boredfifo/Prototyping-Group-2/IR sensor.JPG

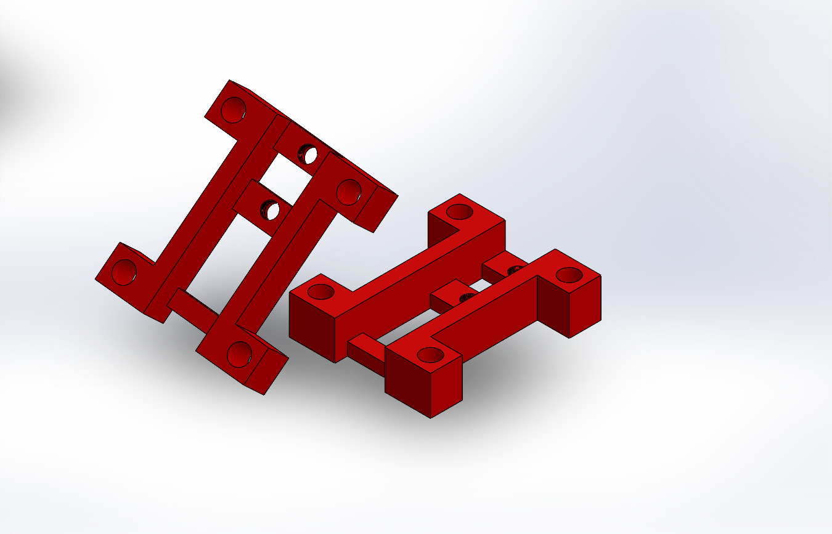
IR sensor.JPG
