boredfifo/Prototyping-Group-2/motor holder.JPG

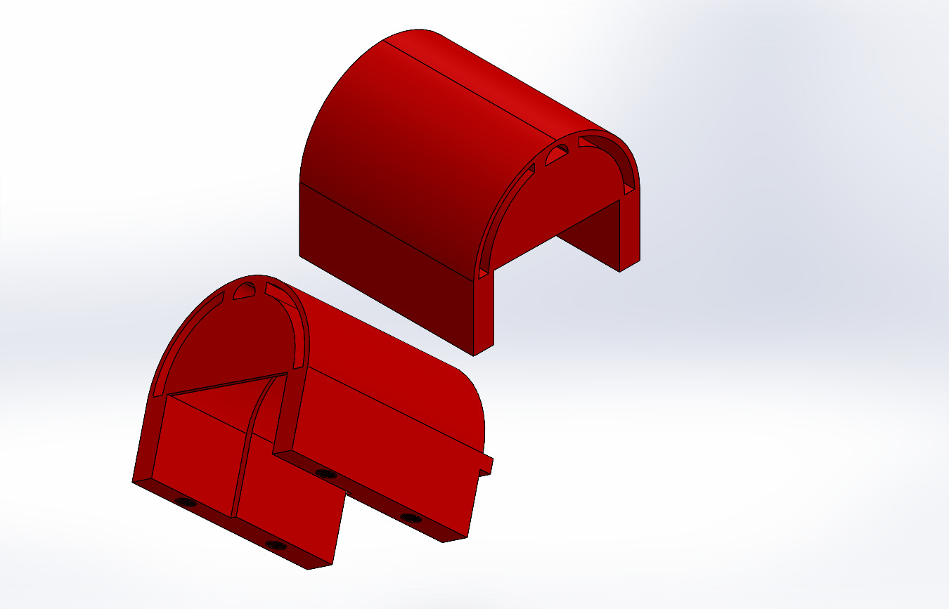
motor holder.JPG
