boredfifo/Prototyping-Group-2/README.md

# Prototyping-Group-2
Moiz Zaheer Malik,
Akinwande Mofifoluwa Ipadeola,
Karimi Arya,
Qaiser Mustafa,
