boredfifo/Prototyping-Group-2/Activity Diagram Prototyping.jpeg

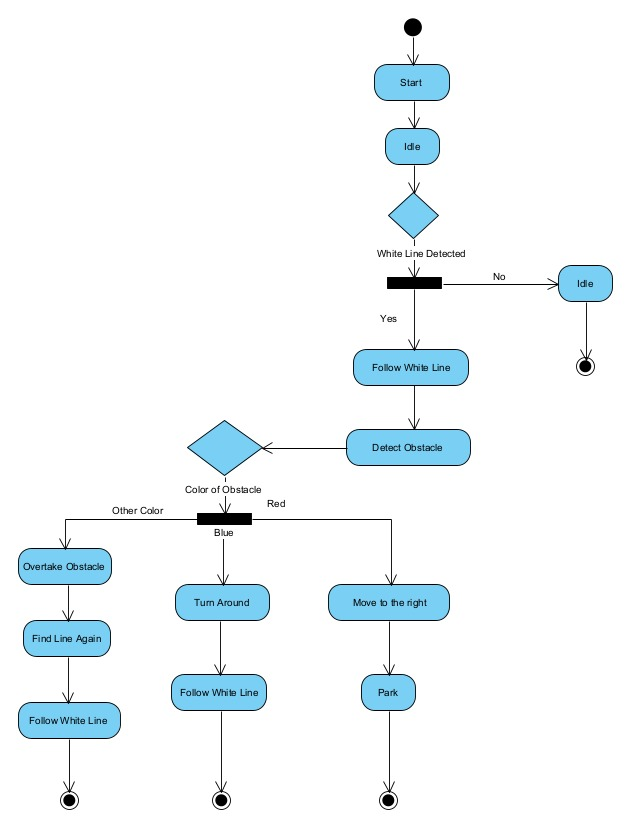
Activity Diagram Prototyping.jpeg
