boredfifo/Prototyping-Group-2/back wall.jpg

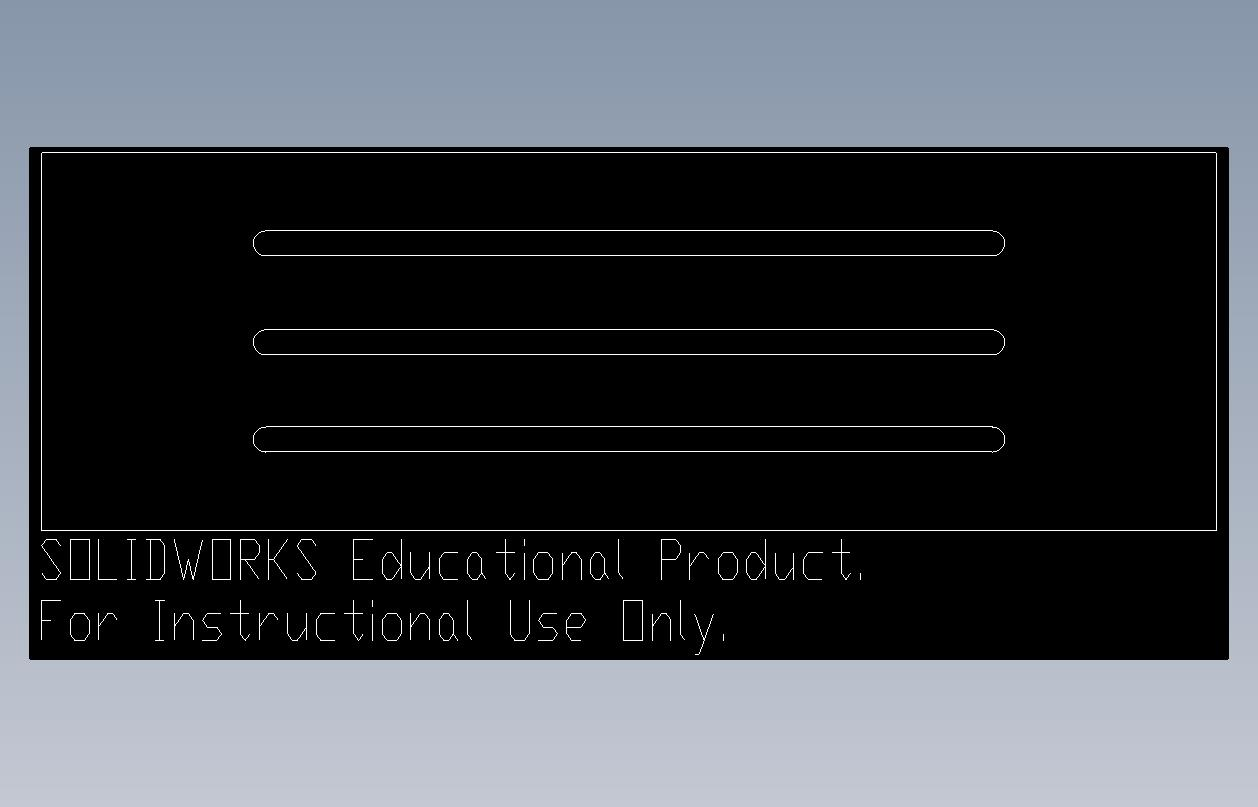
back wall.jpg
