boredfifo/Prototyping-Group-2/color sensor.JPG

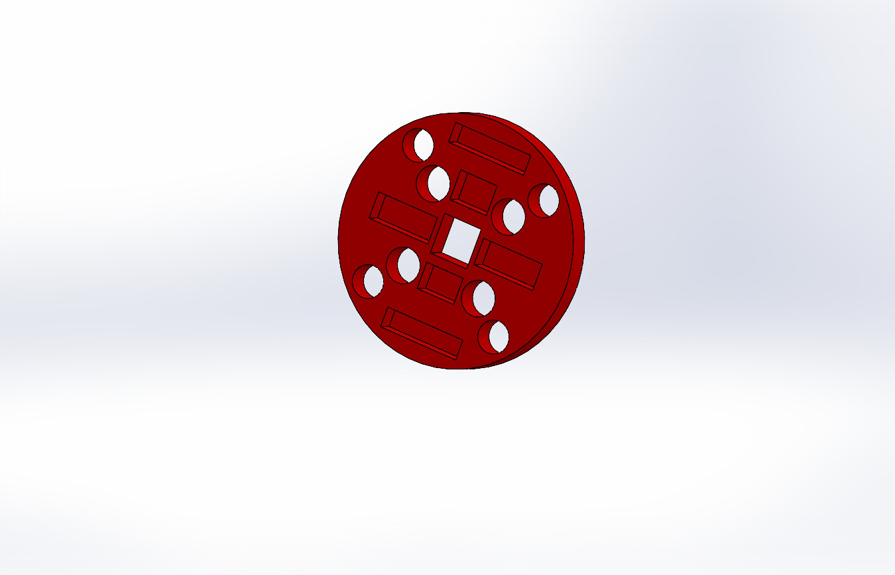
color sensor.JPG
