boredfifo/Prototyping-Group-2/front curved wall.jpg

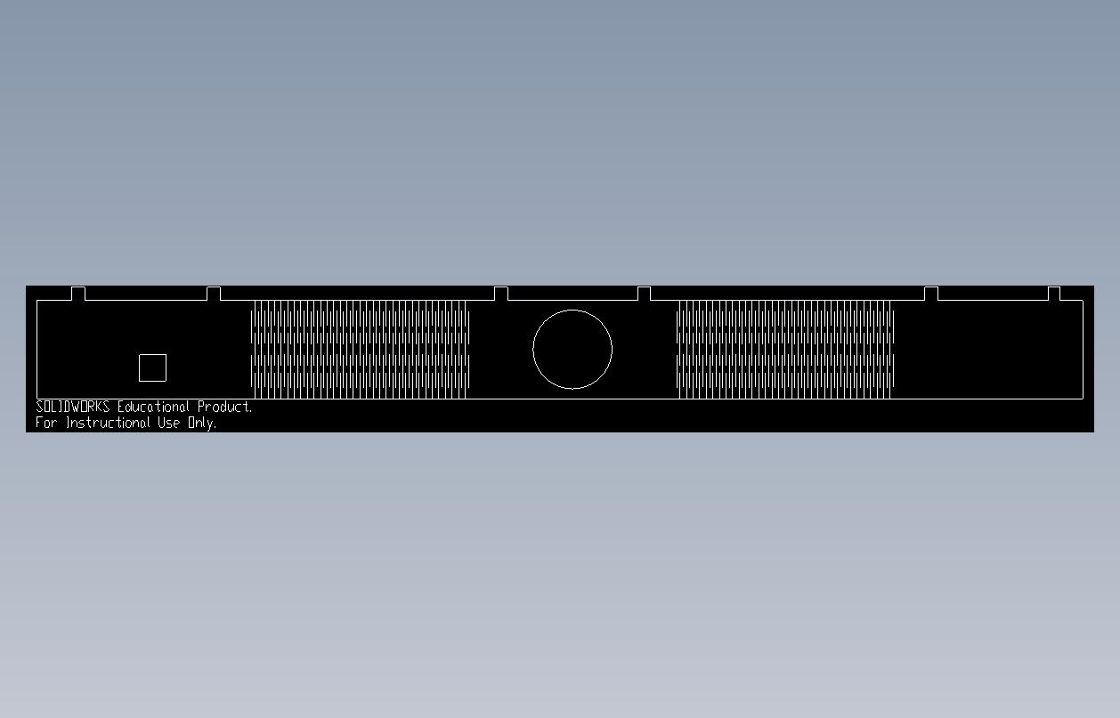
front curved wall.jpg
