boredfifo/Prototyping-Group-2/main body bottom 2.JPG

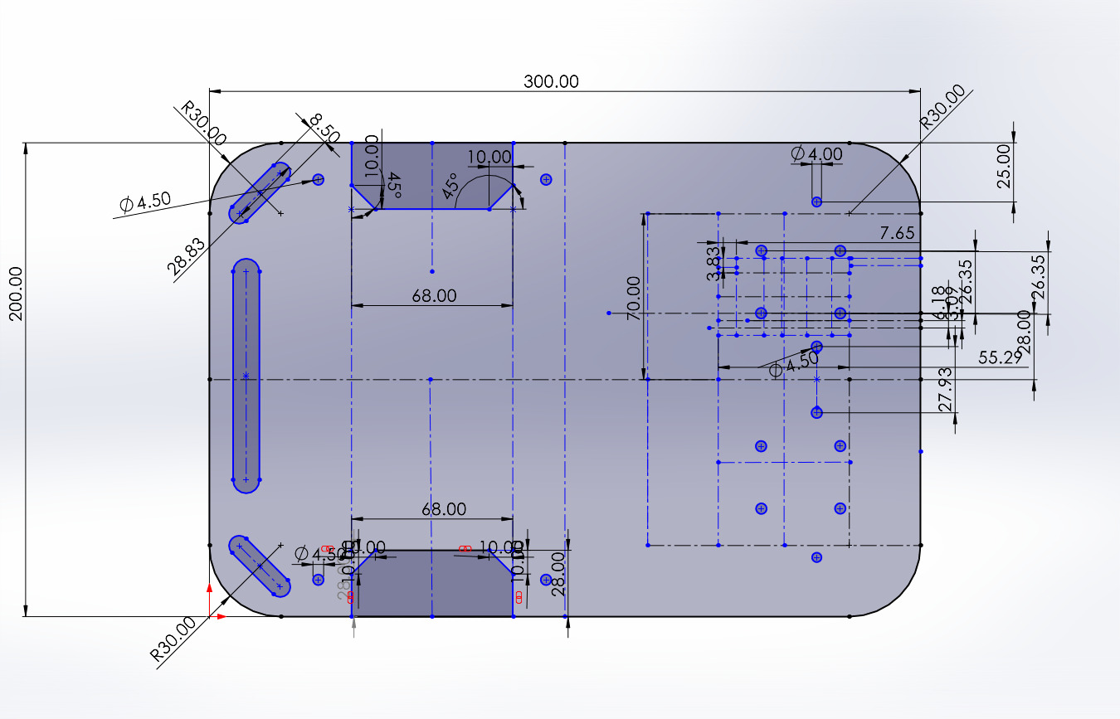
main body bottom 2.JPG
