boredfifo/Prototyping-Group-2/requirment digram.jpg

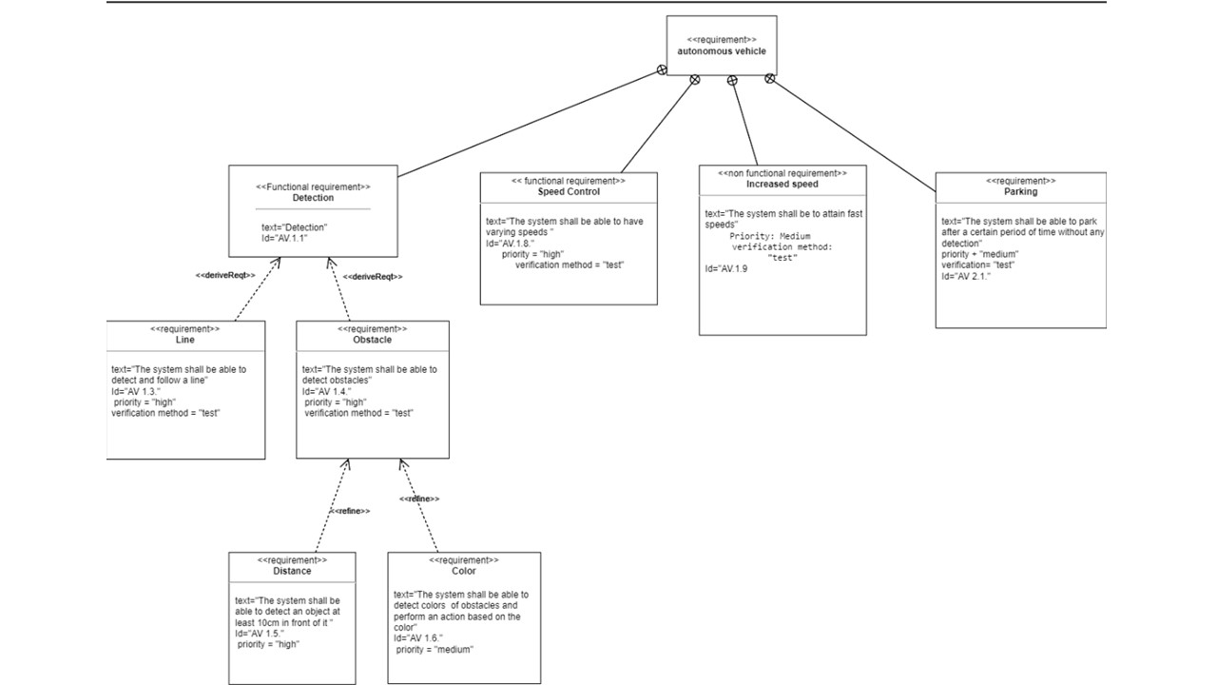
requirment digram.jpg
