boredfifo/Prototyping-Group-2/Slide1.JPG

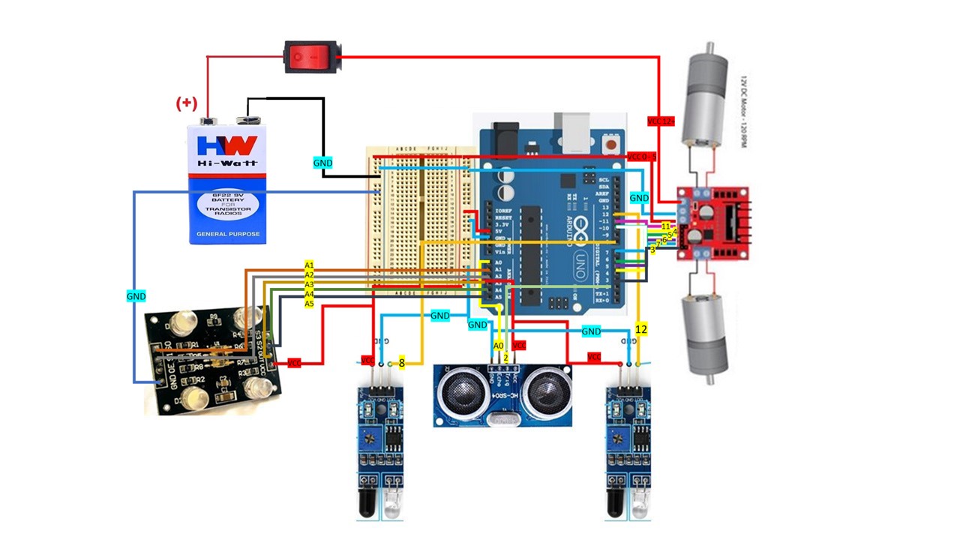
Slide1.JPG
