boredfifo/Prototyping-Group-2/solidworkspart.jpg

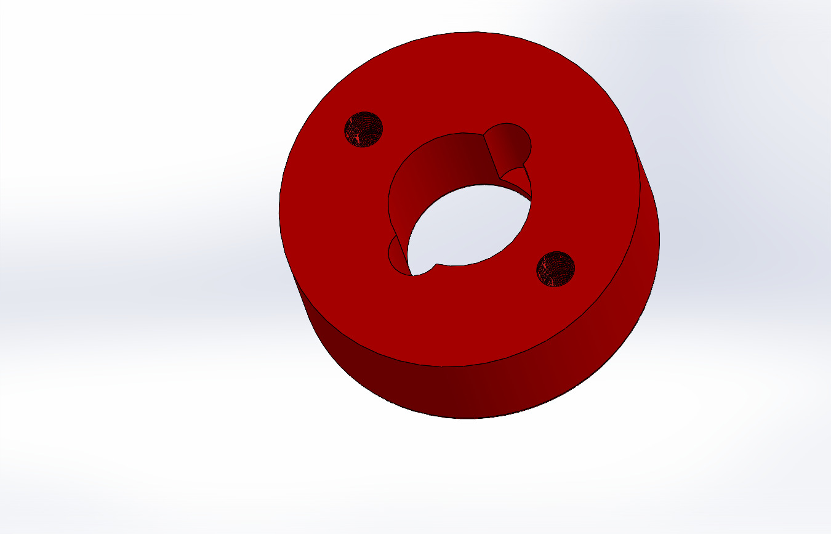
solidworkspart.jpg
