boredfifo/Prototyping-Group-2/state chart.png

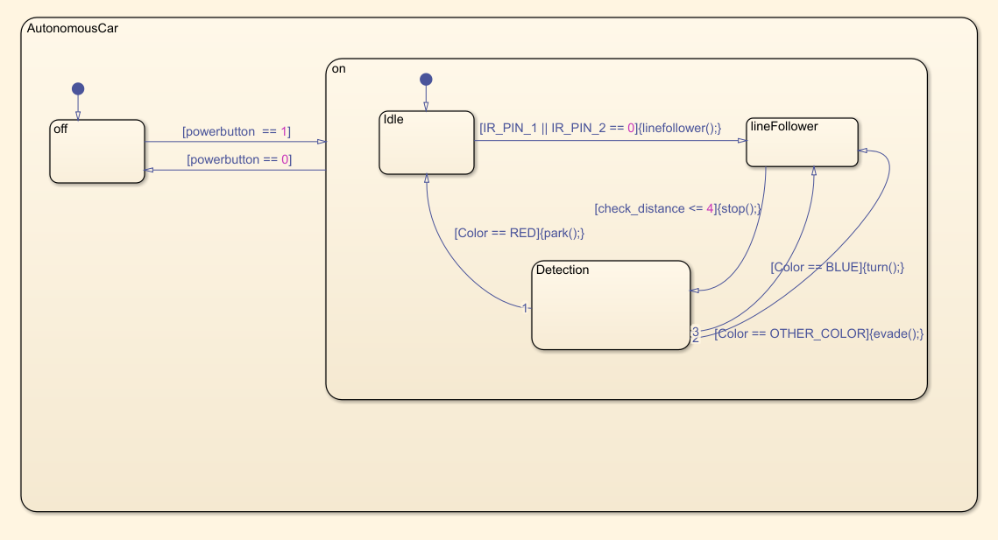
state chart.png
