boredfifo/Prototyping-Group-2/swp1.jpg

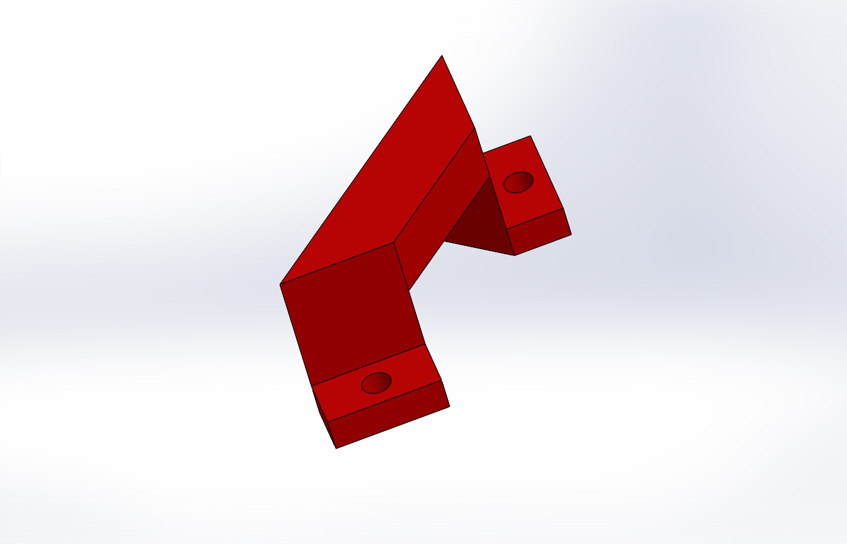
swp1.jpg
