boredfifo/Prototyping-Group-2/swp2.jpg

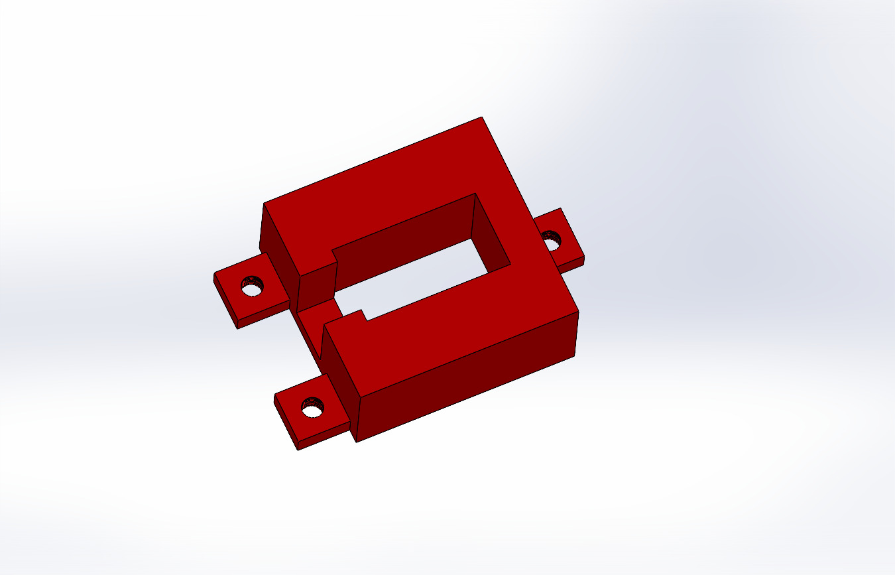
swp2.jpg
