boredfifo/Prototyping-Group-2/swp3.jpg

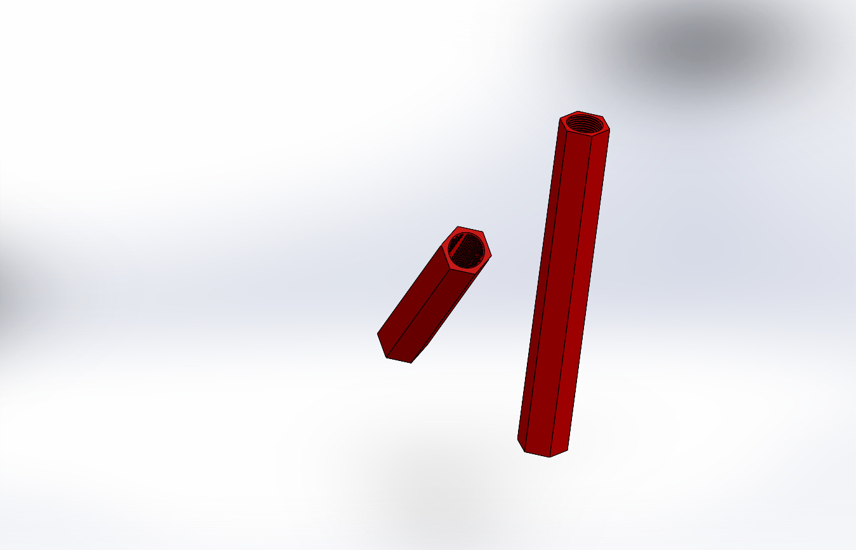
swp3.jpg
