boredfifo/Prototyping-Group-2/Systems Diagram Prototyping.jpeg

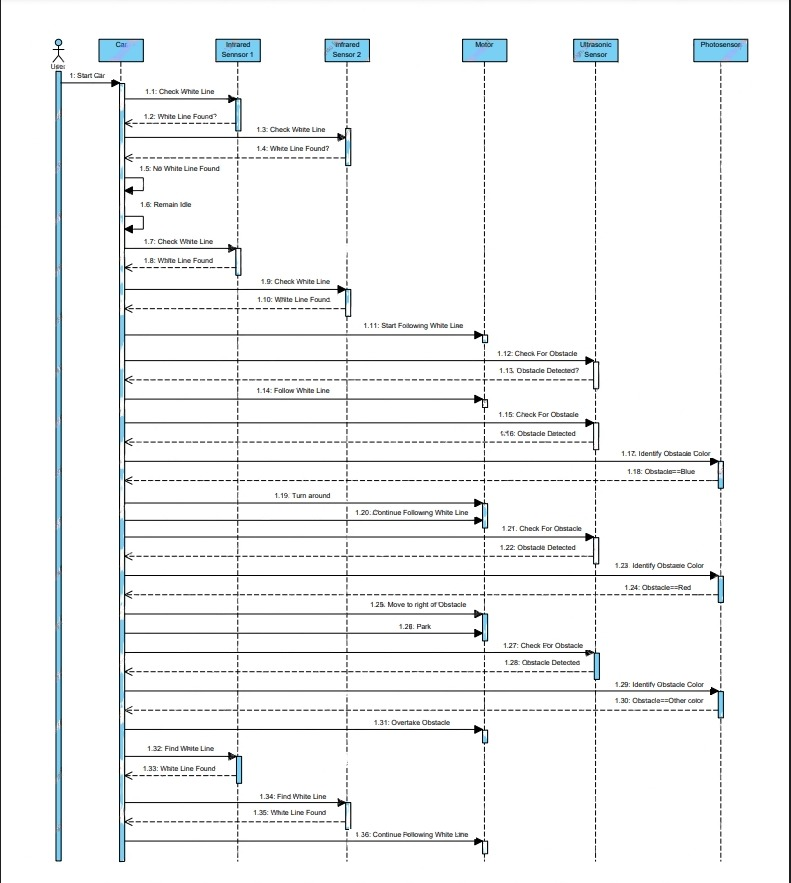
Systems Diagram Prototyping.jpeg
