boredfifo/Prototyping-Group-2/top body part.JPG

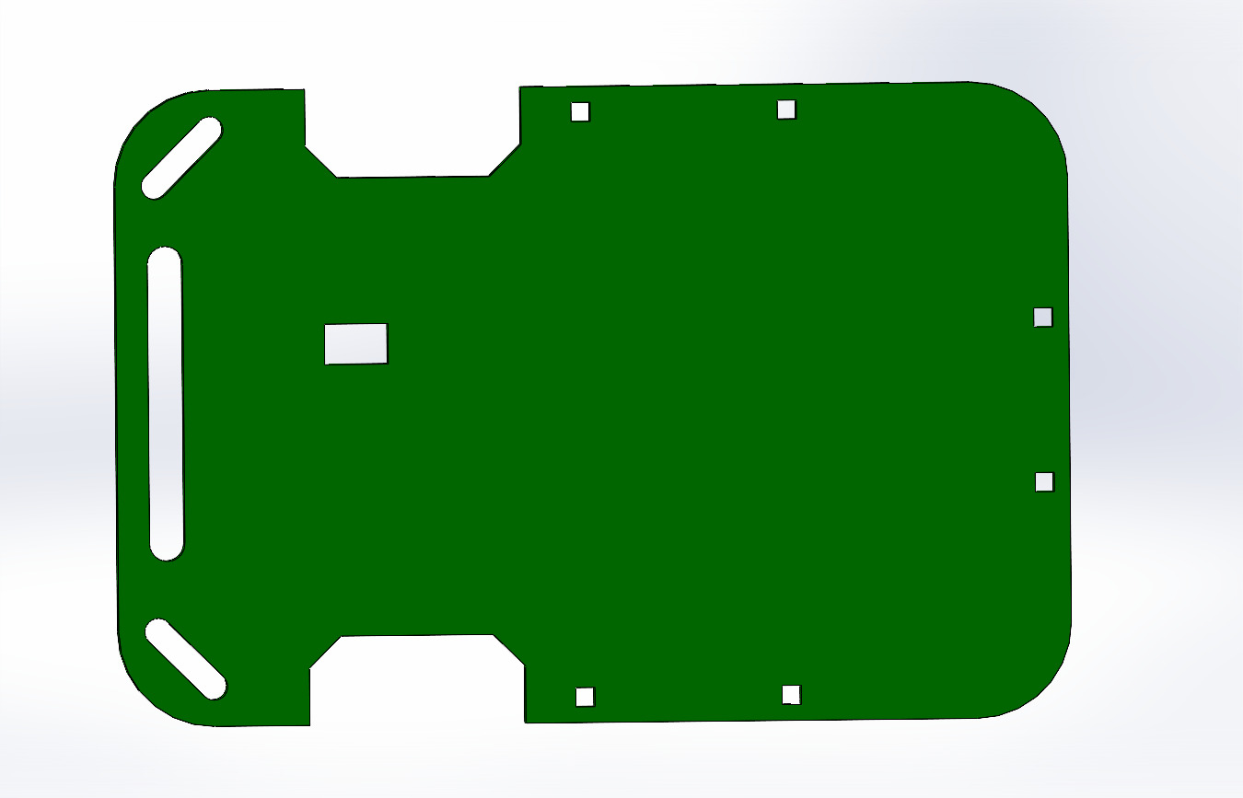
top body part.JPG
