boredfifo/Prototyping-Group-2/Untitled (1).jpg

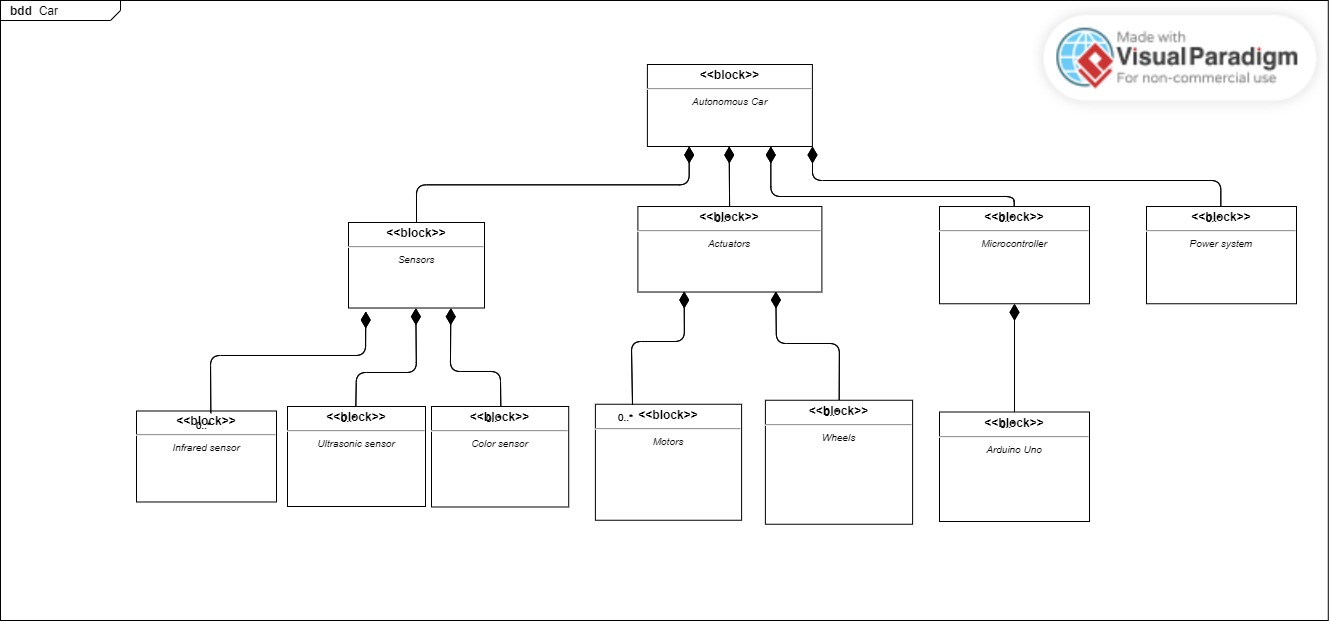
Untitled (1).jpg
