boredfifo/Prototyping-Group-2/main body new.SLDPRT

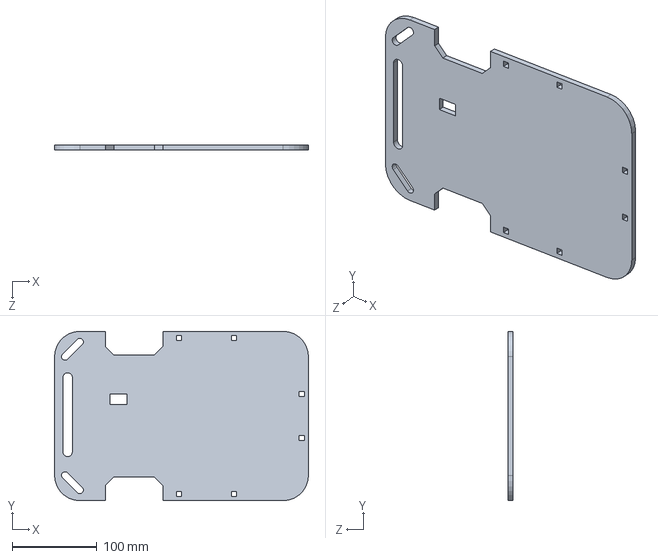
[picture p52: CAD file, 2024-06-20]
main body new.SLDPRT
300.0 x 200.0 x 6.00 mm
