boredfifo/Prototyping-Group-2/main body bottom.DXF

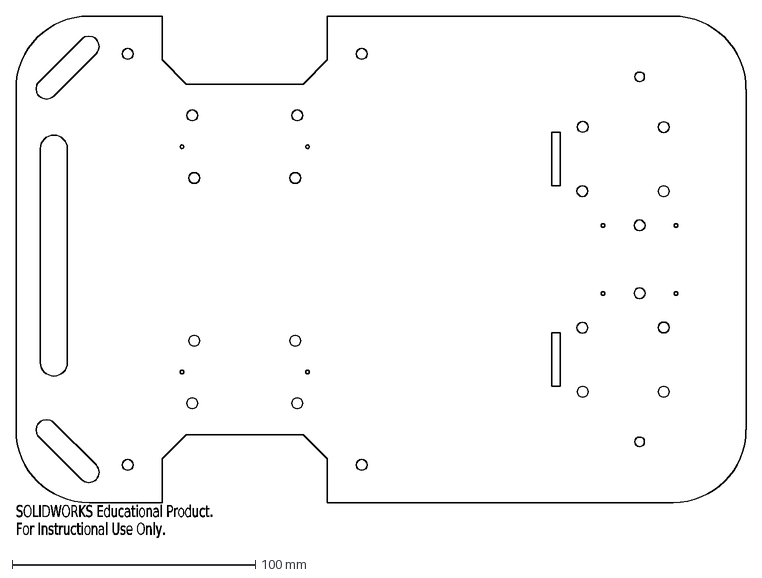
[picture p53: CAD file, 2024-06-20]
main body bottom.DXF
SOLIDWORKS Educational Product.
For Instructional Use Only.
