boredfifo/Prototyping-Group-2/ir.SLDPRT

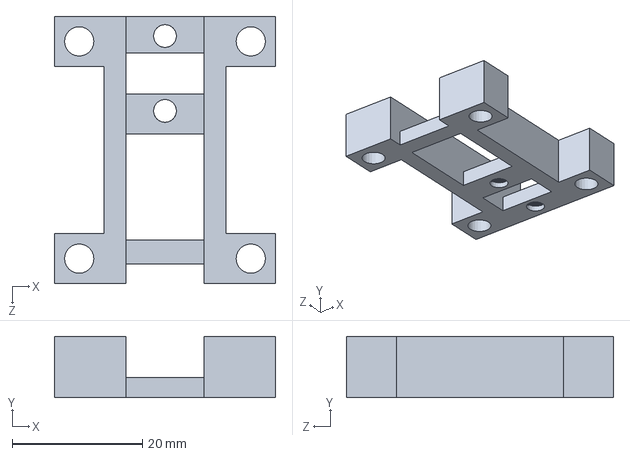
[picture p54: CAD file, 2024-06-22]
ir.SLDPRT
34.0 x 9.40 x 41.0 mm
