boredfifo/Prototyping-Group-2/3rd wheel holder.SLDPRT

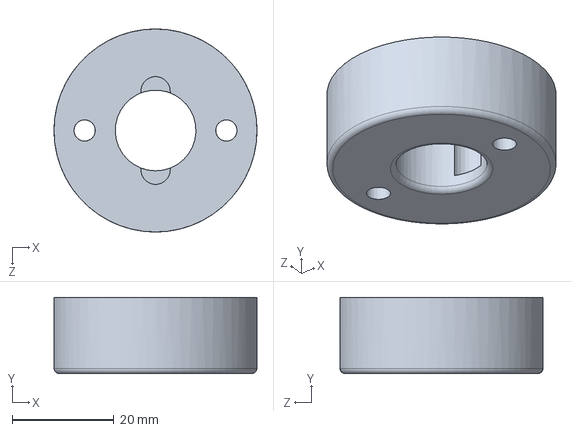
[picture p55: CAD file, 2024-06-22]
3rd wheel holder.SLDPRT
40.0 x 15.0 x 40.0 mm
