boredfifo/Prototyping-Group-2/ultra cover (2).SLDPRT

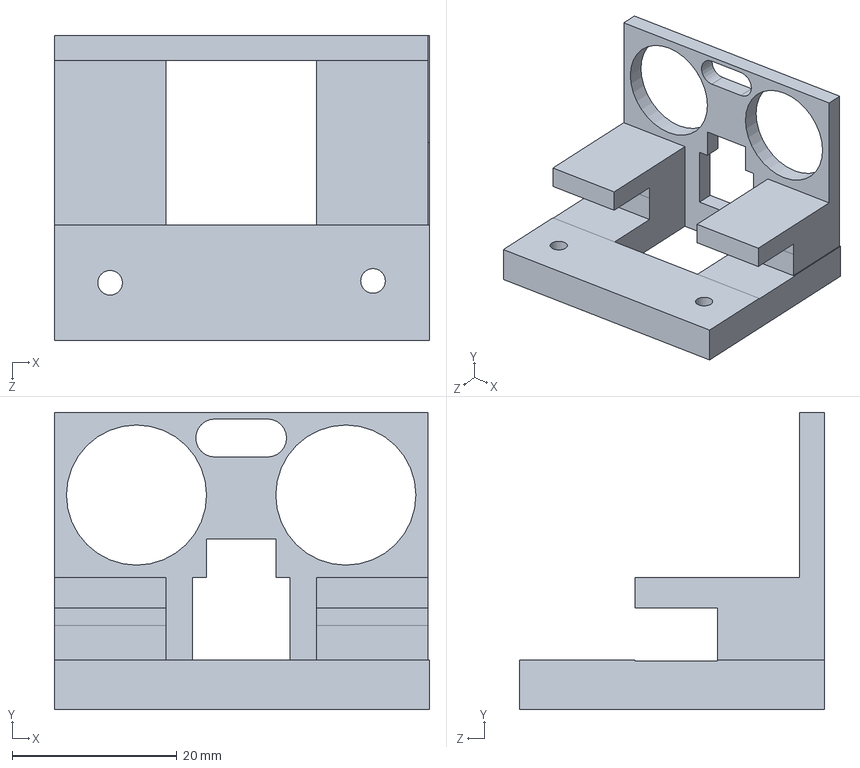
[picture p56: CAD file, 2024-06-21]
ultra cover (2).SLDPRT
45.5 x 36.1 x 37.0 mm
