boredfifo/Prototyping-Group-2/front curved wall.DXF

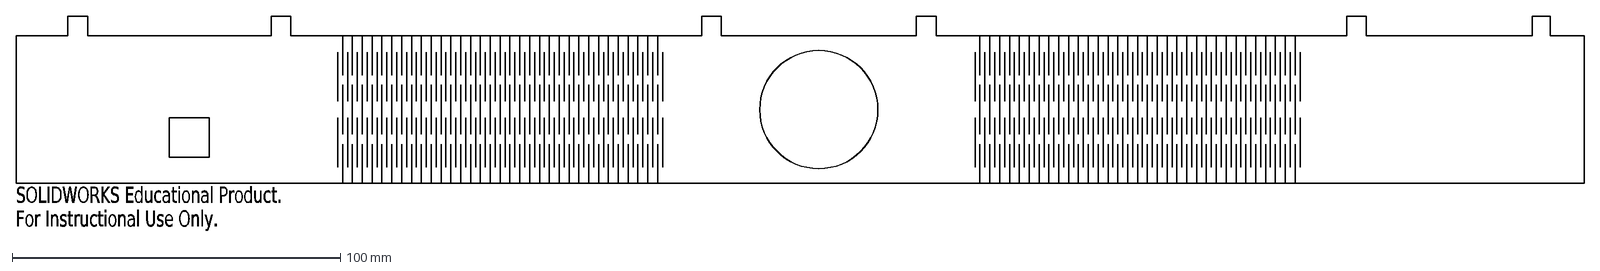
[picture p57: CAD file, 2024-06-20]
front curved wall.DXF
SOLIDWORKS Educational Product.
For Instructional Use Only.
