boredfifo/Prototyping-Group-2/back wall.SLDPRT

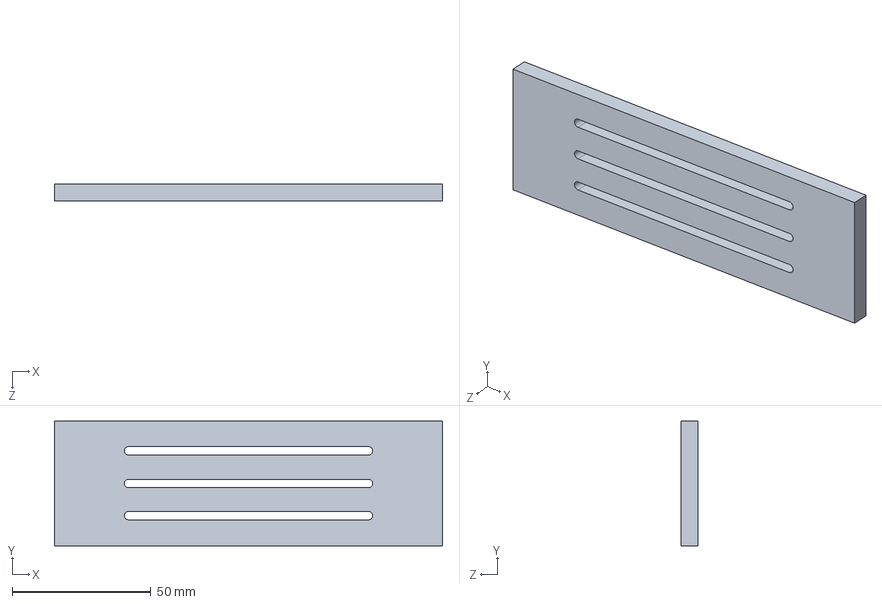
[picture p58: CAD file, 2024-06-20]
back wall.SLDPRT
140.0 x 45.0 x 6.00 mm
