boredfifo/Prototyping-Group-2/mototr cover.SLDPRT

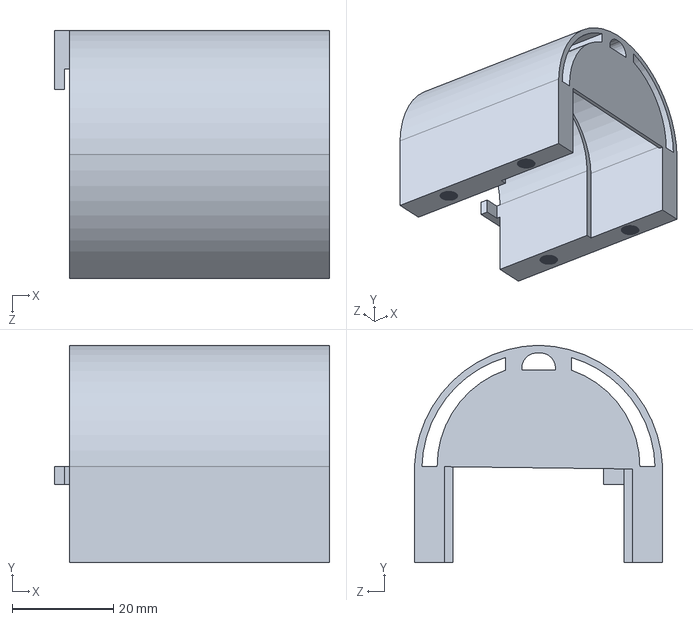
[picture p59: CAD file, 2024-06-20]
mototr cover.SLDPRT
54.4 x 43.0 x 49.1 mm
