boredfifo/Prototyping-Group-2/(list of files, cad)

Other CAD files:
main body top.SLDPRT
back wall.DXF
main body top.DXF
