boredfifo/Prototyping-Group-2/Use case diagram.pdf

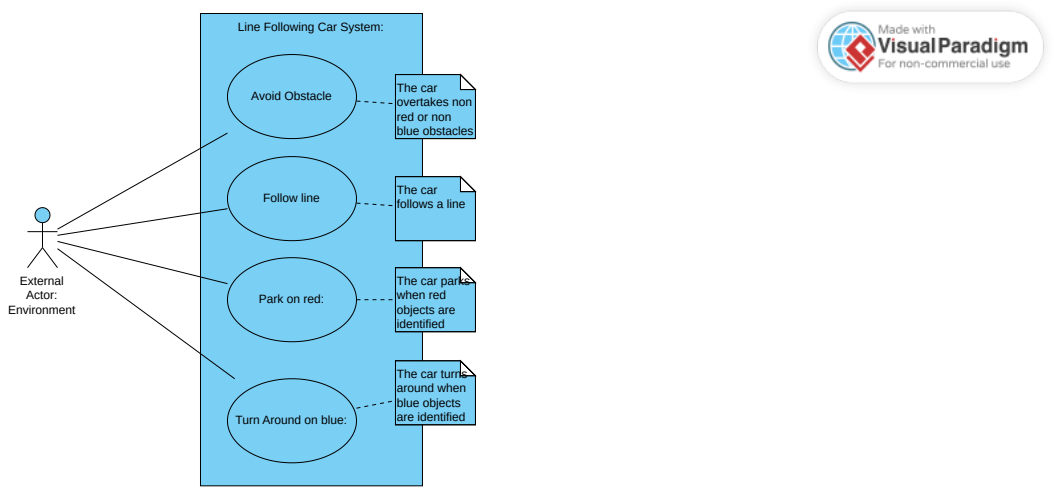
[picture p60: page 1]
Avoid Obstacle; Follow line; External Actor: Environment; The car follows a line

Line Following Car System:

The car
overtakes non
red or non
blue obstacles

The car parks
when red
objects are
identified

Park on red:

The car turns
around when
blue objects
are identified

Turn Around on blue:
