boredfifo/Prototyping-Group-2/(commit log)

2024-06-18 Update pratice.h
    added a new function check_flag to create and update a flag if one of the IR sensors go off
2024-06-21 Add files via upload
    The Cover for the Ultrasonic Sensor
    [ultra cover (2).SLDPRT]
